ayushp06/hackathon-fa26/hackathonfa26 2026.pdf

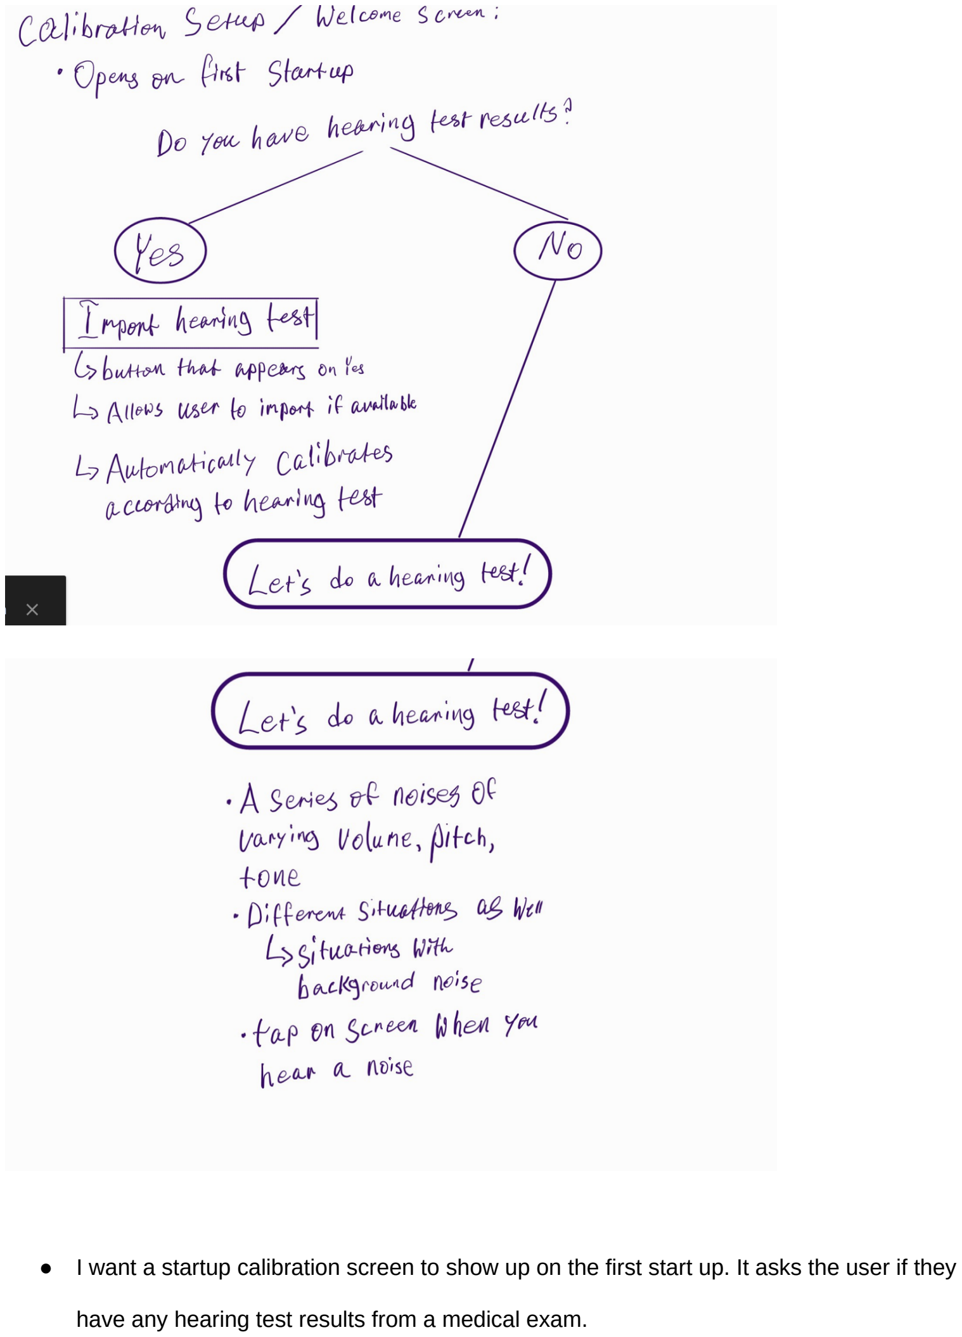
[picture p1: page 1]

- I want a startup calibration screen to show up on the first start up. It asks the user if they

have any hearing test results from a medical exam.

- If they do, it allows the user to import their own hearing test results through a pdf

file or images through an upload or import button

- If they don’t, it brings the user to another screen where they do a hearing test:

they tap the screen every time they hear a noise.

- This screen should also ask them the questions: “Which sounds do you want to be

louder?”, followed by the following headers with yes / no buttons beside them

- Vocal tones?
- Background noise?
- Emphasize softer or louder tones?

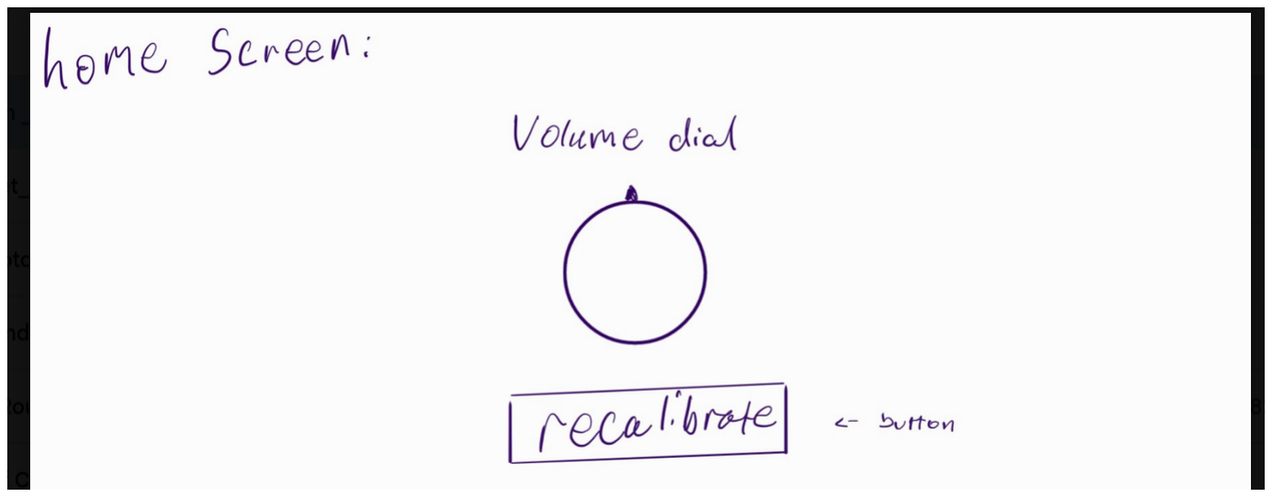
[picture p2: figure]

- This is the home screen of the app
- It only has a volume dial on it and a recalibration button
- This should be the default screen of the app after the first setup screen
- The recalibration screen should take you to the following manual calibration screen:

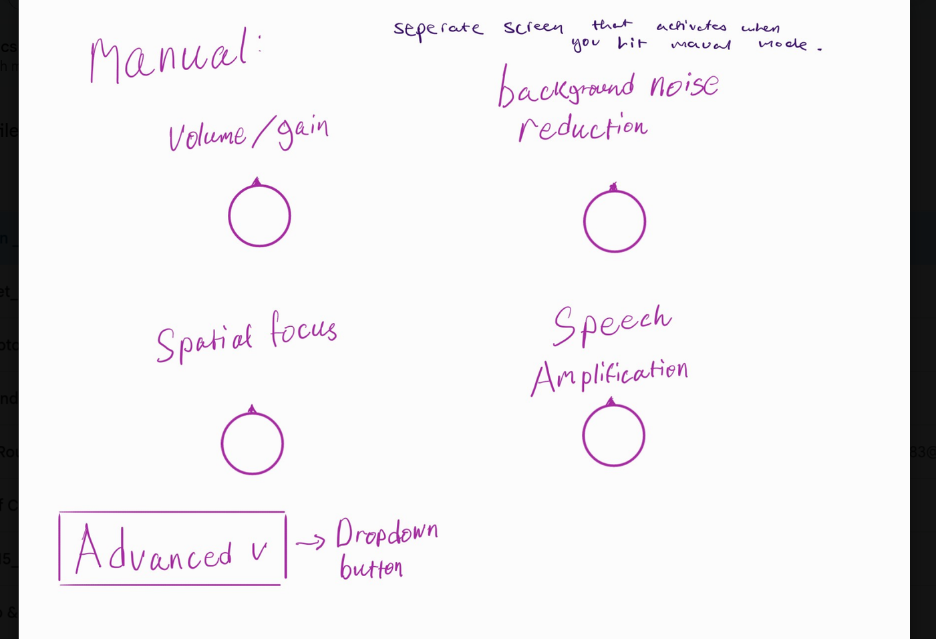
[picture p3: figure]
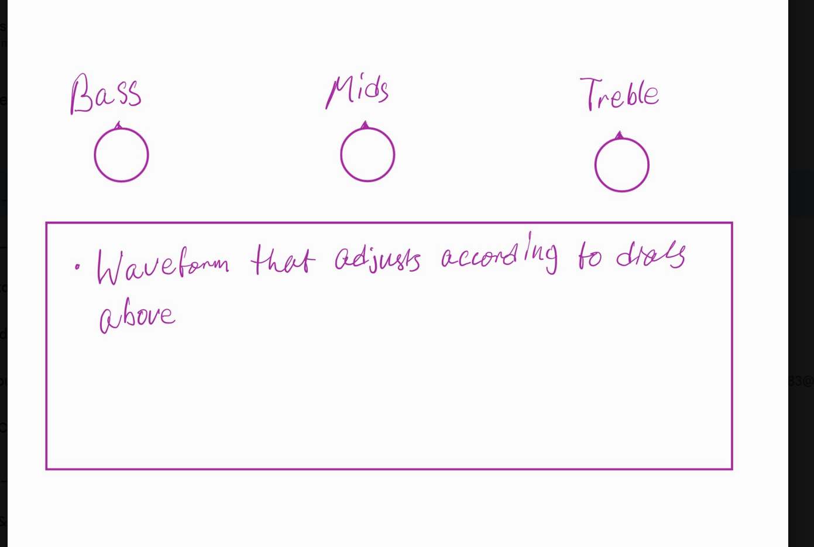
[picture p4: figure]

- This screen shows up if you change the automatic calibration / manual slider to be set to

manual.

- I want to add this advanced drop down button with bass, mid, and treble dials and a

wave form that changes according to the values of the dials
