ayushp06/hackathon-fa26/hardware/exports/AURA_breadboard_schematic.pdf

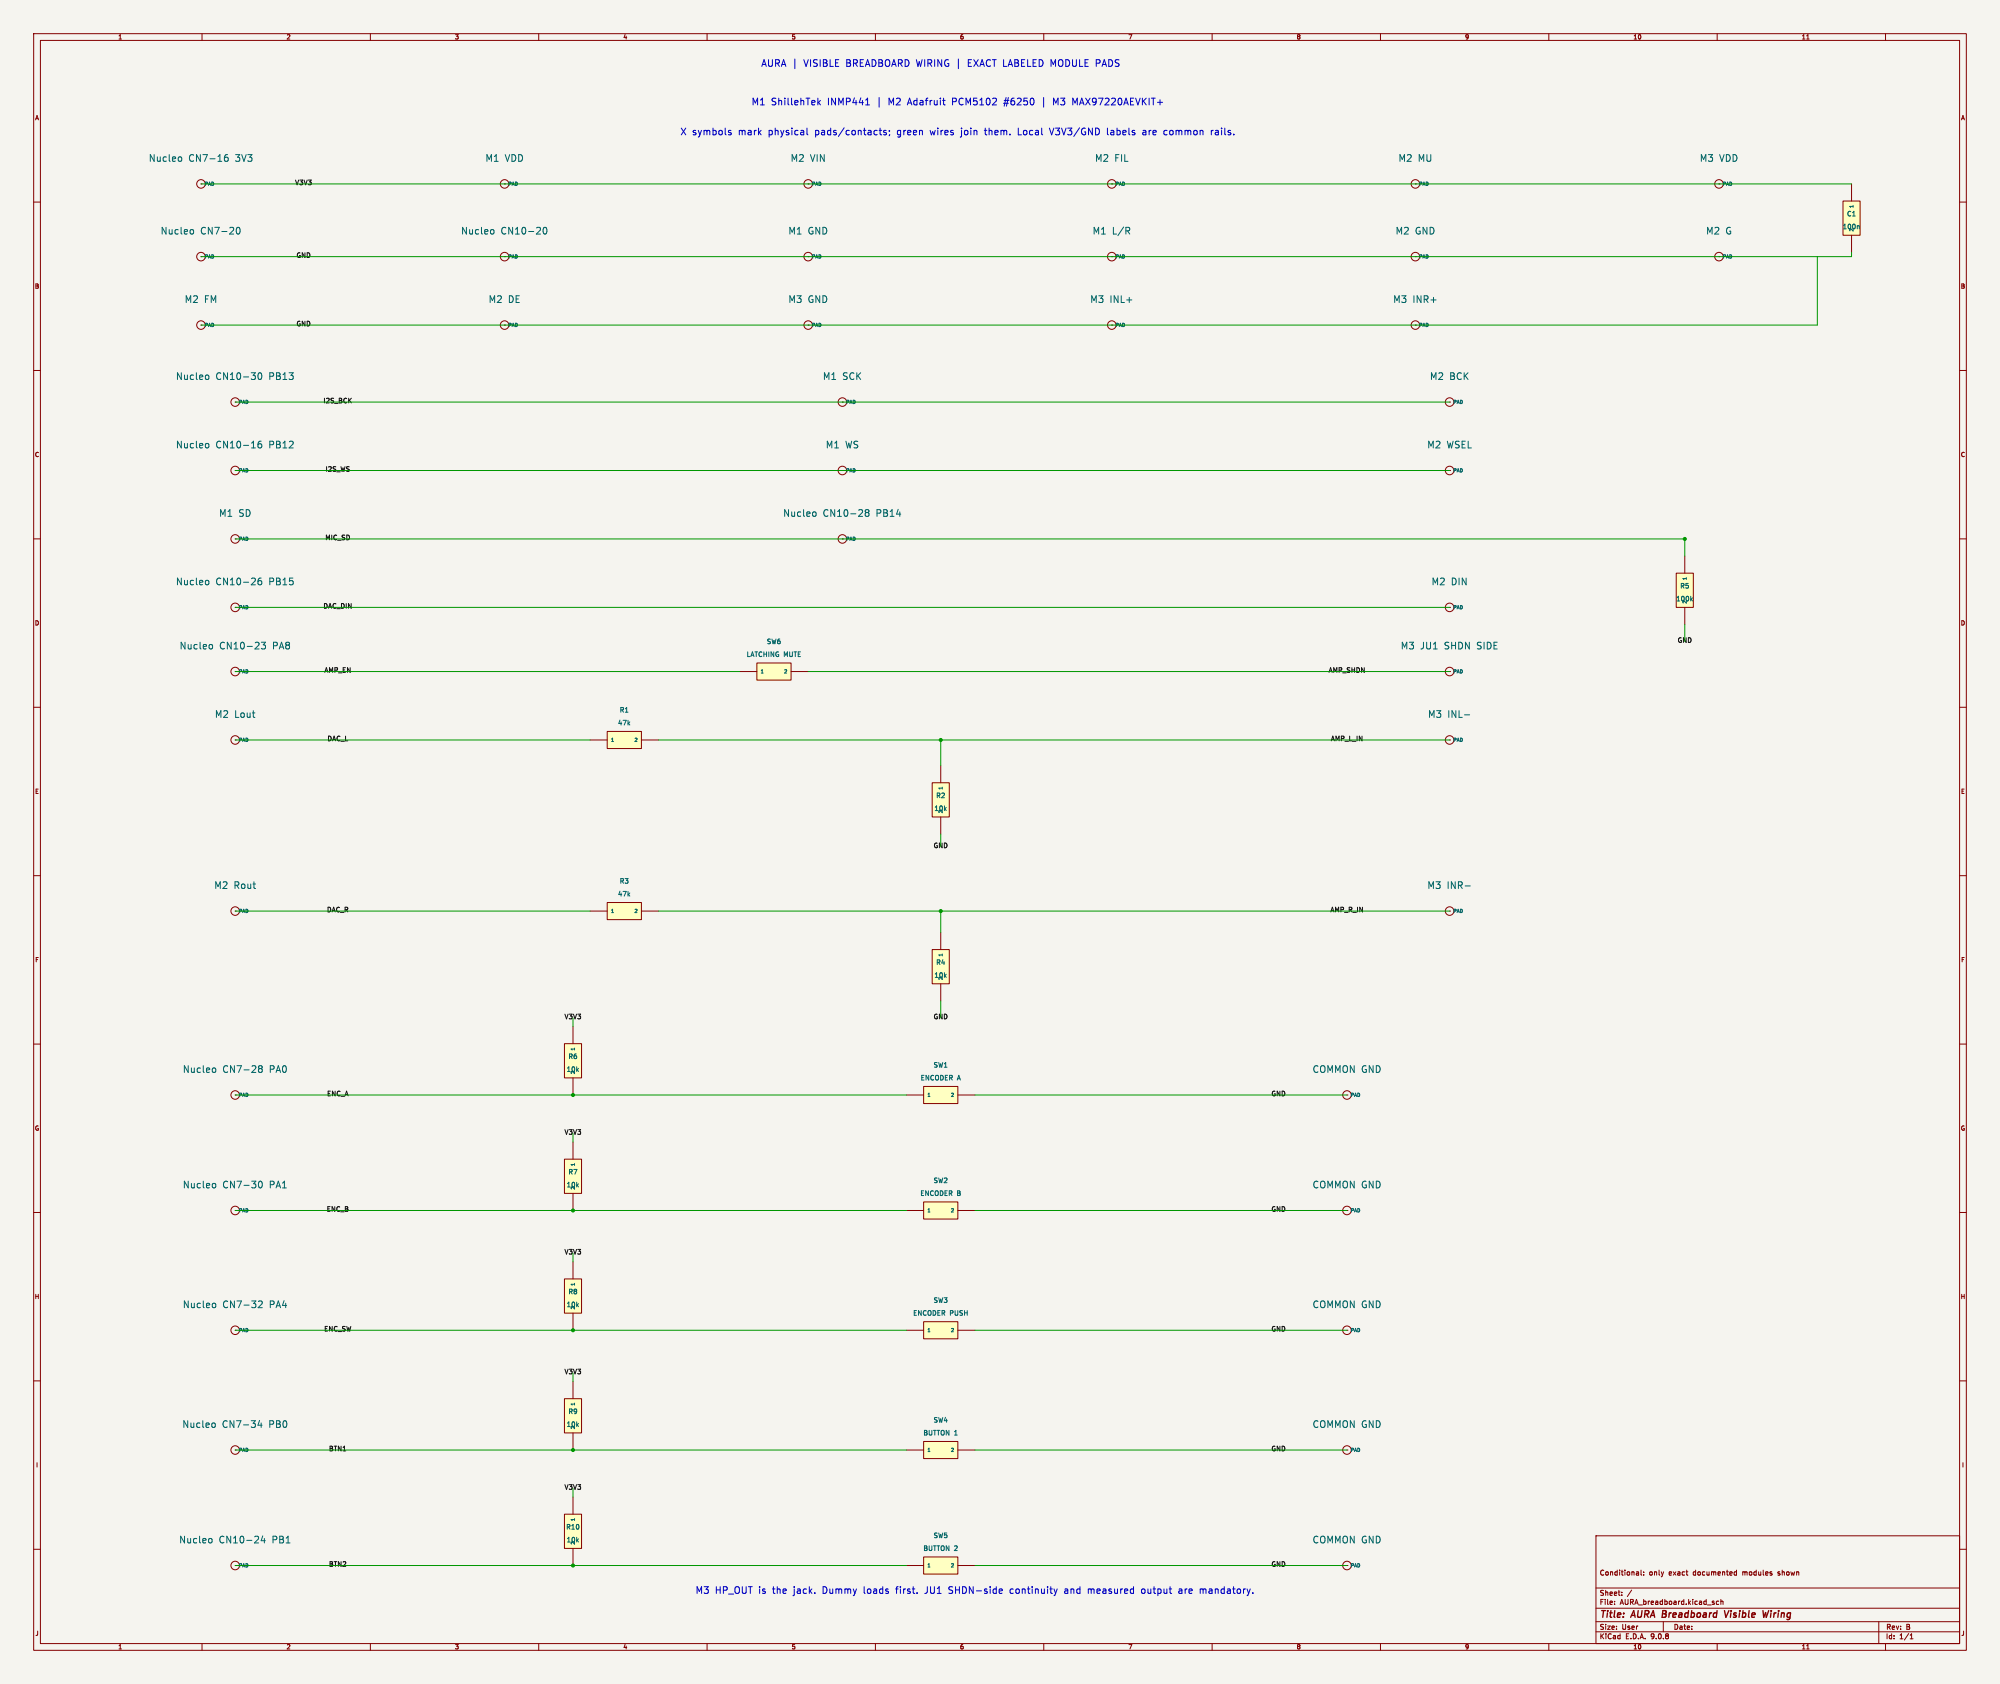
[picture p5: page 1]

AURA | VISIBLE BREADBOARD WIRING | EXACT LABELED MODULE PADS

PAD M3 INL- PAD M3 INR-
