ayushp06/hackathon-fa26/hardware/exports/AURA_circuit_schematic.pdf

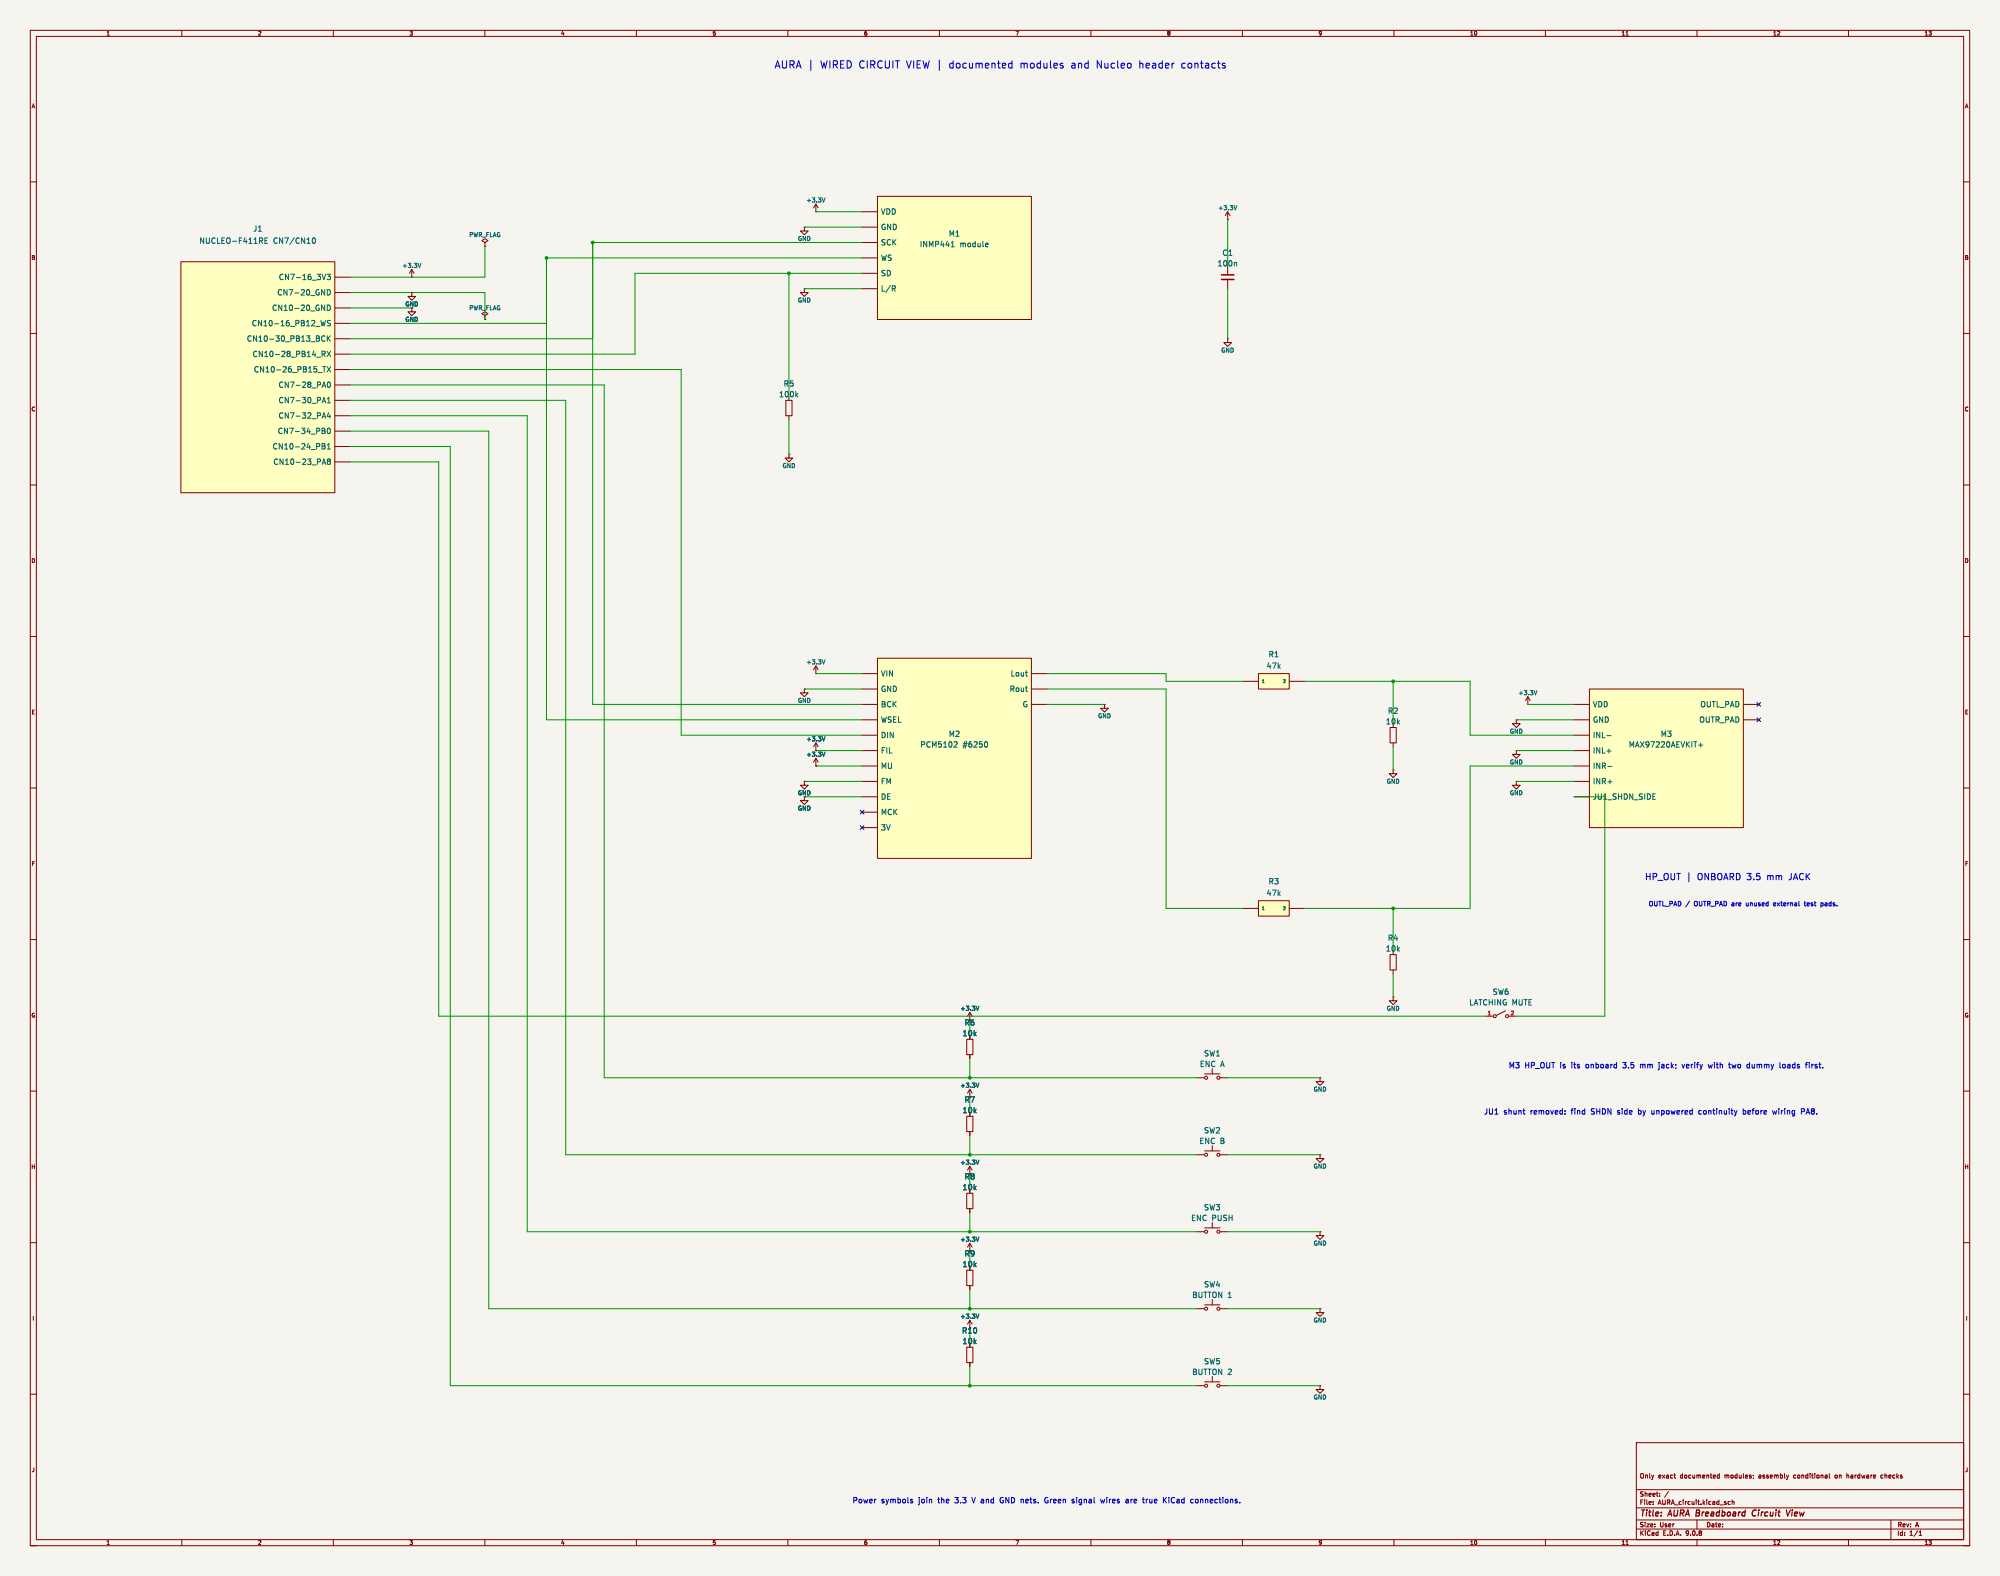
[picture p6: page 1]

M3 HP_OUT is its onboard 3.5 mm jack; verify with two dummy loads first.

Power symbols join the 3.3 V and GND nets. Green signal wires are true KiCad connections.

Id: 1/1 Title: AURA Breadboard Circuit View
