ayushp06/hackathon-fa26/hardware/AURA_schematic.pdf

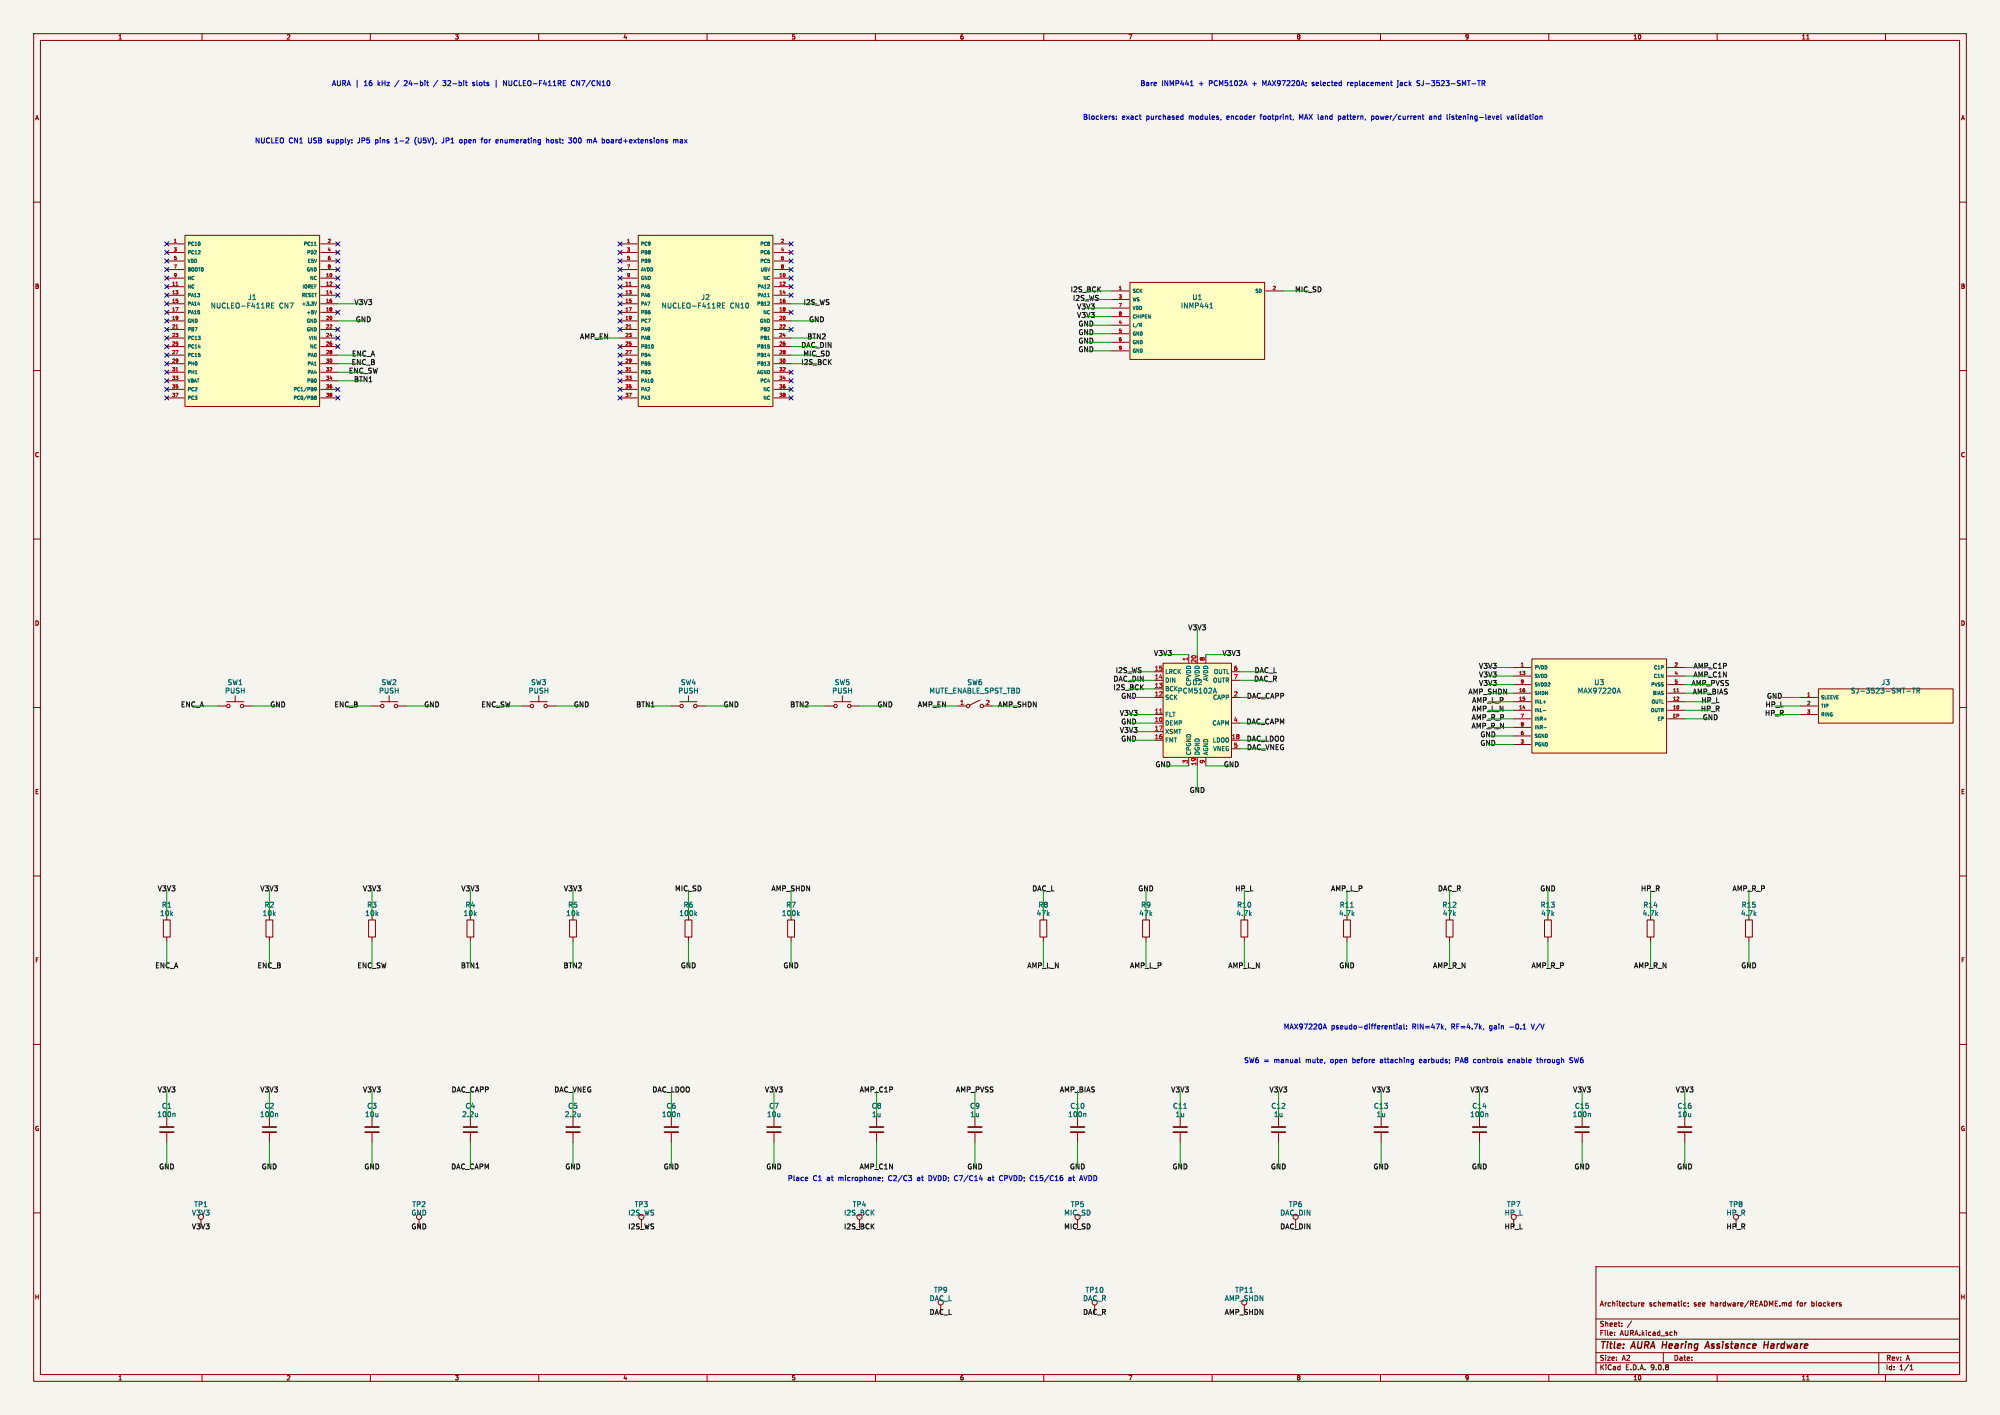
[picture p7: page 1]
