ayushp06/hackathon-fa26/hardware/AURA.kicad_sch

## KiCad design hardware/AURA.kicad_sch (2026-10-24)

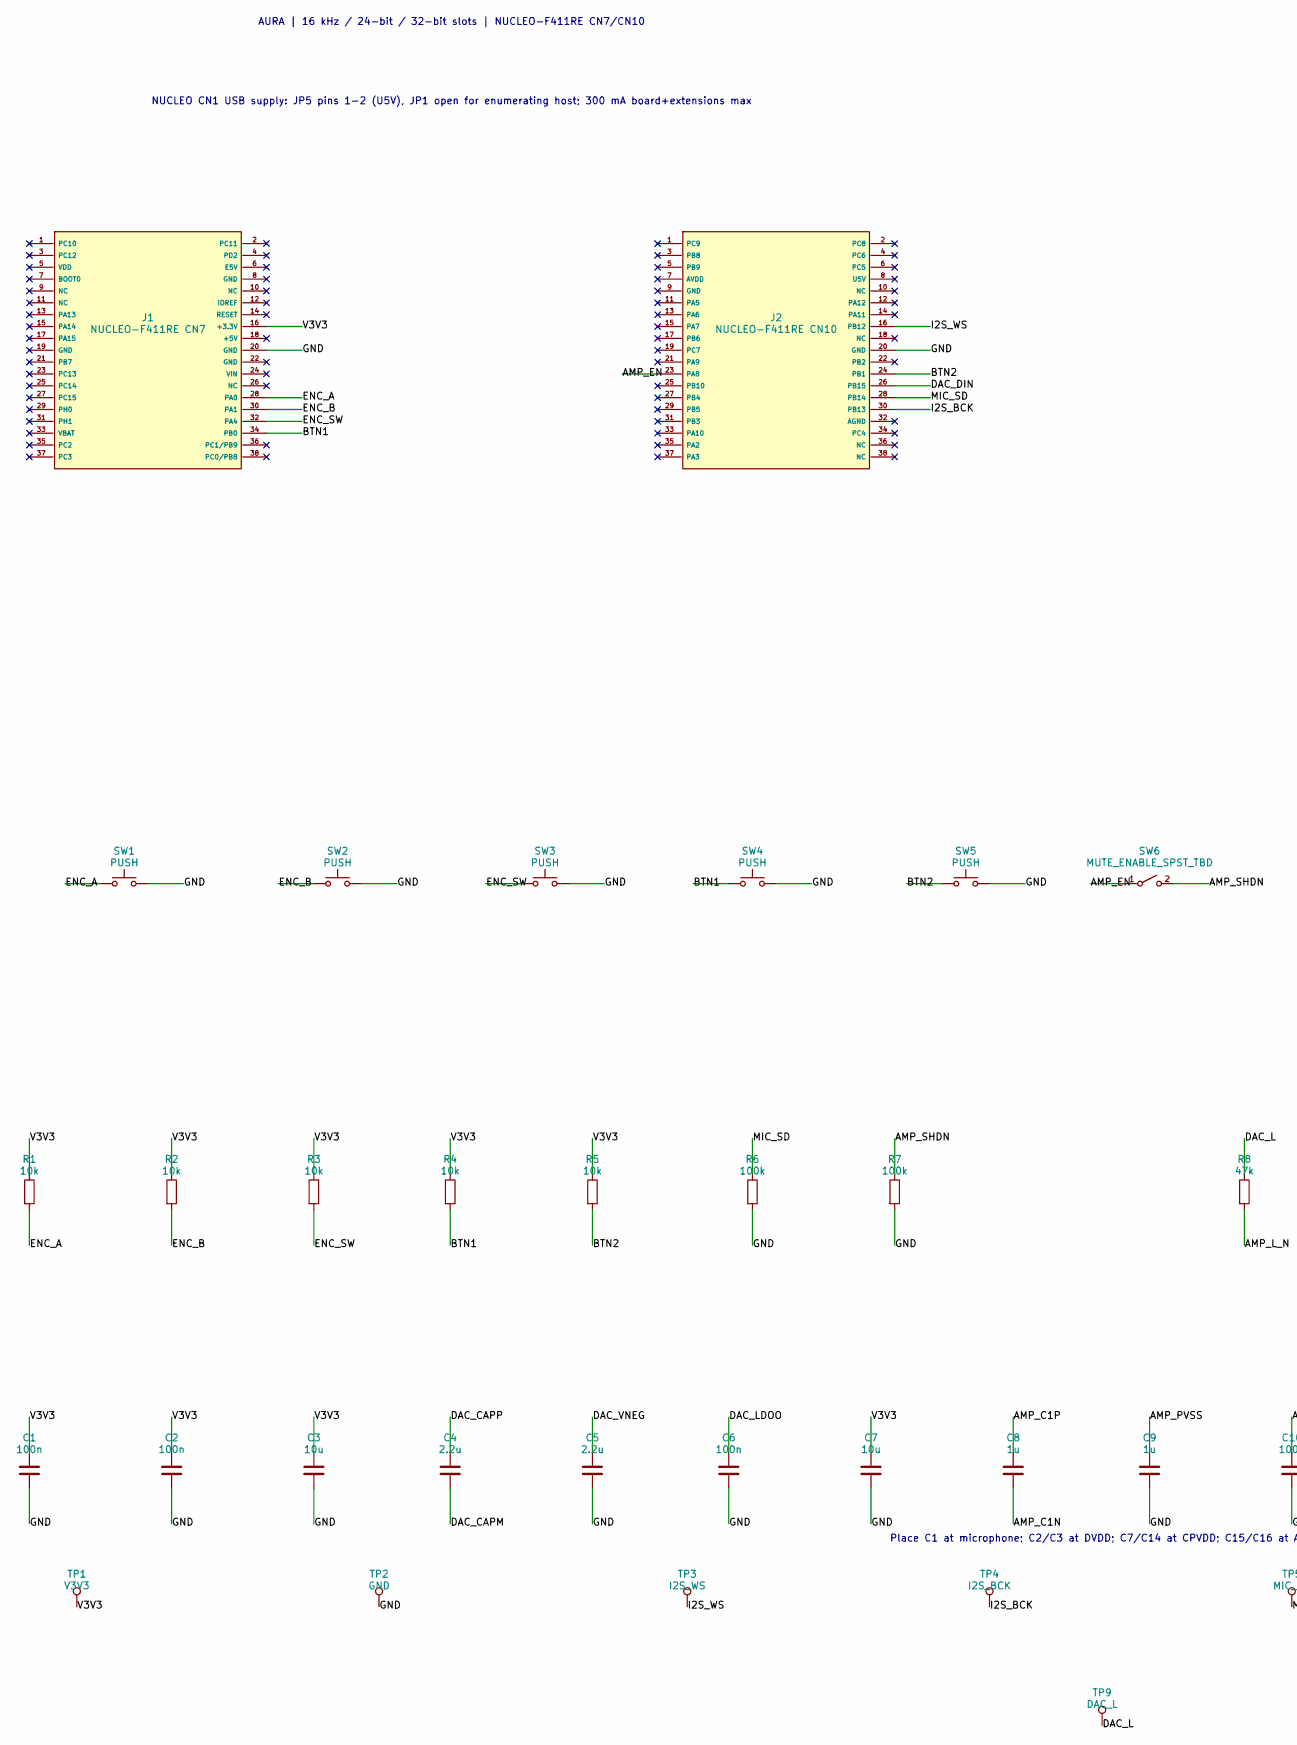
[picture p8: schematic AURA.kicad_sch, part in row 1, column 1]

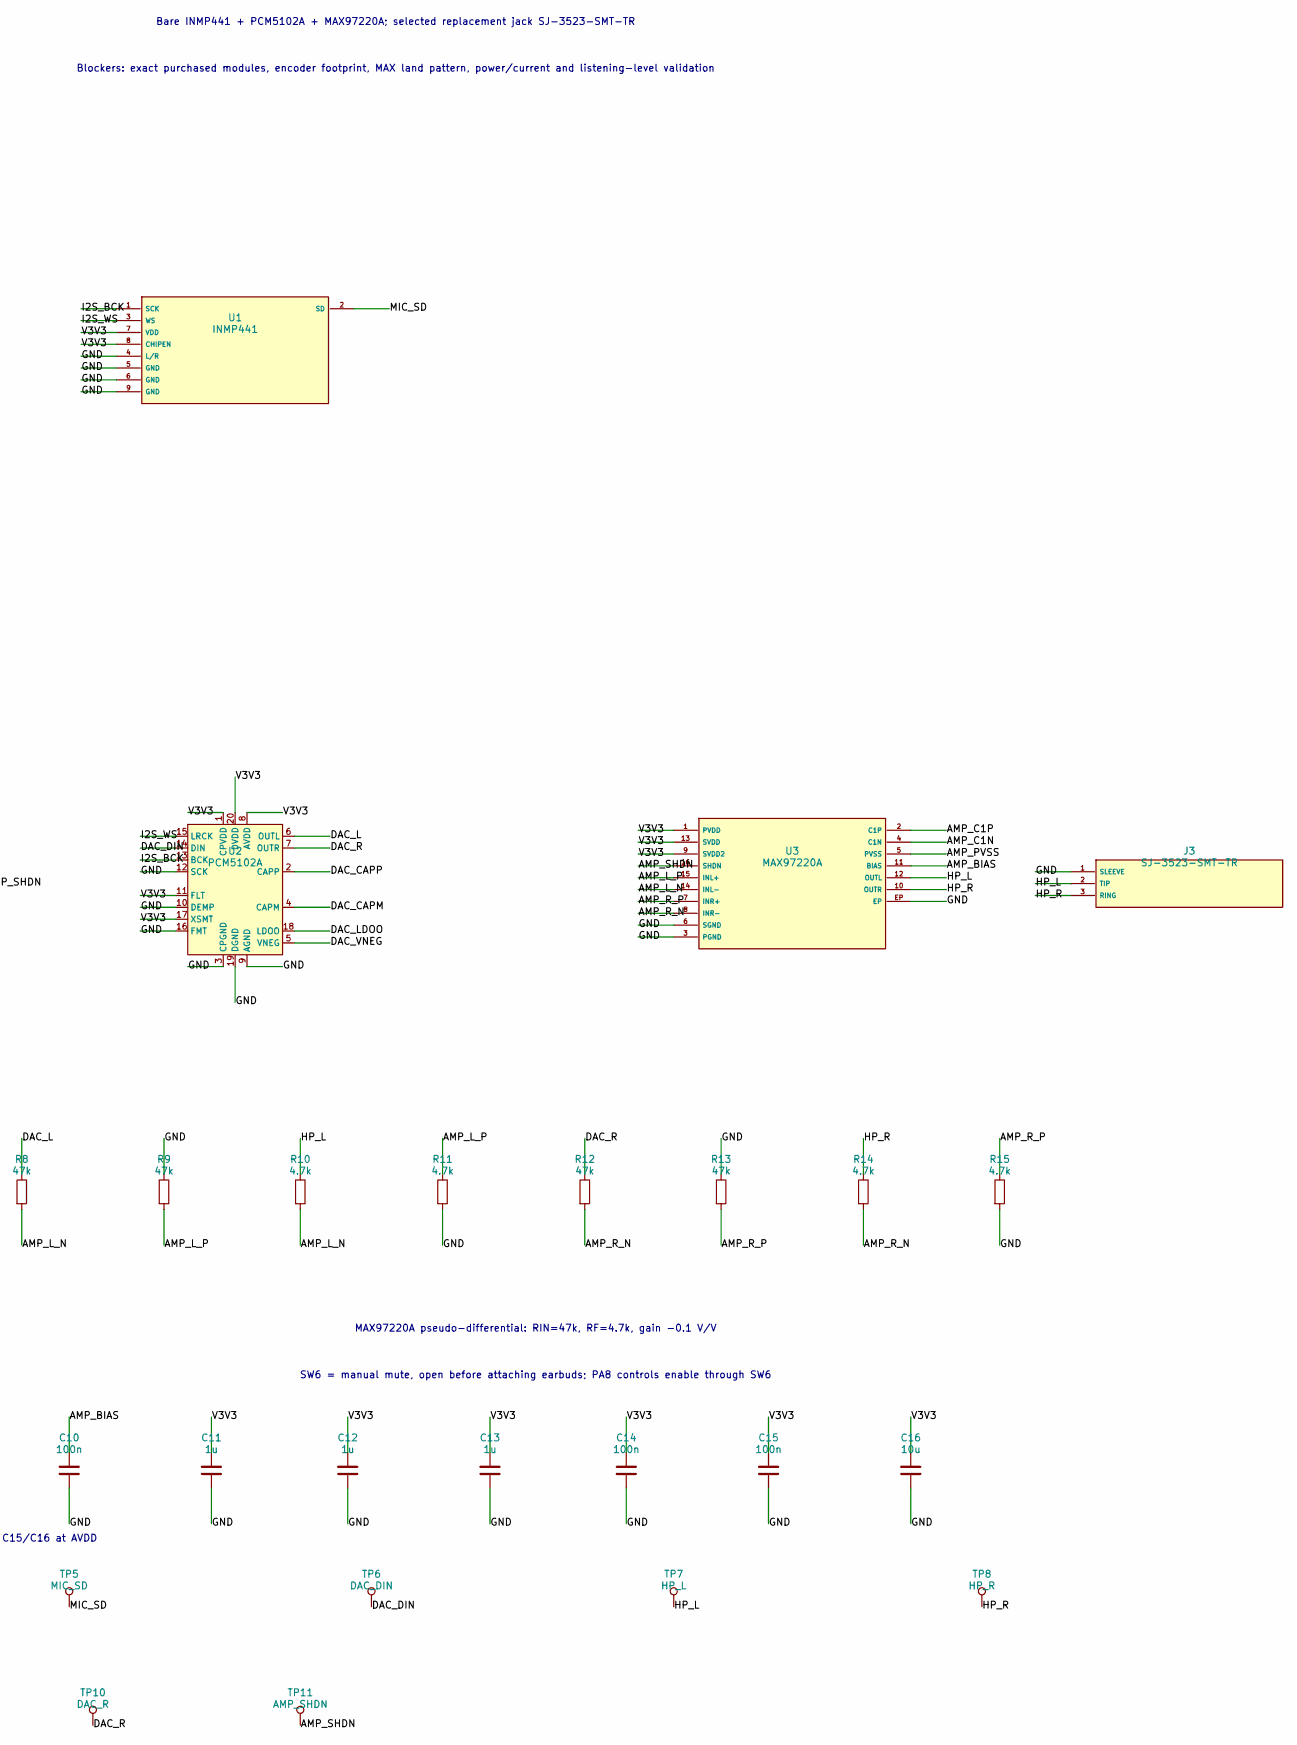
[picture p9: schematic AURA.kicad_sch, part in row 1, column 2]

Parts:
C1, C2, C6, C10, C14, C15: 100n; C_0603_1608Metric
C3, C7, C16: 10u; C_0603_1608Metric
C4, C5: 2.2u; C_0603_1608Metric
C8, C9, C11, C12, C13: 1u; C_0603_1608Metric
J1: NUCLEO-F411RE CN7
J2: NUCLEO-F411RE CN10
J3: SJ-3523-SMT-TR; Jack_3.5mm_CUI_SJ-3523-SMT-TR
R1, R2, R3, R4, R5: 10k; R_0603_1608Metric
R6, R7: 100k; R_0603_1608Metric
R8, R9, R12, R13: 47k; R_0603_1608Metric
R10, R11, R14, R15: 4.7k; R_0603_1608Metric
SW1, SW2, SW3, SW4, SW5: PUSH
SW6: MUTE_ENABLE_SPST_TBD
TP1: V3V3
TP2: GND
TP3: I2S_WS
TP4: I2S_BCK
TP5: MIC_SD
TP6: DAC_DIN
TP7: HP_L
TP8: HP_R
TP9: DAC_L
TP10: DAC_R
TP11: AMP_SHDN
U1: INMP441
U2: PCM5102A; TSSOP-20_4.4x6.5mm_P0.65mm
U3: MAX97220A

Connections:
AMP_BIAS: C10.1, U3.11 (BIAS)
AMP_C1N: C8.2, U3.4 (C1N)
AMP_C1P: C8.1, U3.2 (C1P)
AMP_EN: J2.23 (PA8), SW6.1 (A)
AMP_L_N: R8.2, R10.2, U3.14 (INL-)
AMP_L_P: R9.2, R11.1, U3.15 (INL+)
AMP_PVSS: C9.1, U3.5 (PVSS)
AMP_R_N: R12.2, R14.2, U3.8 (INR-)
AMP_R_P: R13.2, R15.1, U3.7 (INR+)
AMP_SHDN: R7.1, SW6.2 (B), TP11.1, U3.16 (SHDN)
BTN1: J1.34 (PB0), R4.2, SW4.1
BTN2: J2.24 (PB1), R5.2, SW5.1
DAC_CAPM: C4.2, U2.4 (CAPM)
DAC_CAPP: C4.1, U2.2 (CAPP)
DAC_DIN: J2.26 (PB15), TP6.1, U2.14 (DIN)
DAC_L: R8.1, TP9.1, U2.6 (OUTL)
DAC_LDOO: C6.1, U2.18 (LDOO)
DAC_R: R12.1, TP10.1, U2.7 (OUTR)
DAC_VNEG: C5.1, U2.5 (VNEG)
ENC_A: J1.28 (PA0), R1.2, SW1.1
ENC_B: J1.30 (PA1), R2.2, SW2.1
ENC_SW: J1.32 (PA4), R3.2, SW3.1
GND: C1.2, C2.2, C3.2, C5.2, C6.2, C7.2, C9.2, C10.2, C11.2, C12.2, C13.2, C14.2, C15.2, C16.2, J1.20 (GND), J2.20 (GND), J3.1 (SLEEVE), R6.2, R7.2, R9.1, R11.2, R13.1, R15.2, SW1.2, SW2.2, SW3.2, SW4.2, SW5.2, TP2.1, U1.4 (L/R), U1.5 (GND), U1.6 (GND), U1.9 (GND), U2.3 (CPGND), U2.9 (AGND), U2.10 (DEMP), U2.12 (SCK), U2.16 (FMT), U2.19 (DGND), U3.3 (PGND), U3.6 (SGND), U3.EP
HP_L: J3.2 (TIP), R10.1, TP7.1, U3.12 (OUTL)
HP_R: J3.3 (RING), R14.1, TP8.1, U3.10 (OUTR)
I2S_BCK: J2.30 (PB13), TP4.1, U1.1 (SCK), U2.13 (BCK)
I2S_WS: J2.16 (PB12), TP3.1, U1.3 (WS), U2.15 (LRCK)
MIC_SD: J2.28 (PB14), R6.1, TP5.1, U1.2 (SD)
V3V3: C1.1, C2.1, C3.1, C7.1, C11.1, C12.1, C13.1, C14.1, C15.1, C16.1, J1.16 (+3.3V), R1.1, R2.1, R3.1, R4.1, R5.1, TP1.1, U1.7 (VDD), U1.8 (CHIPEN), U2.1 (CPVDD), U2.8 (AVDD), U2.11 (FLT), U2.17 (XSMT), U2.20 (DVDD), U3.1 (PVDD), U3.9 (SVDD2), U3.13 (SVDD)

Notes on the sheet:
AURA | 16 kHz / 24-bit / 32-bit slots | NUCLEO-F411RE CN7/CN10
Bare INMP441 + PCM5102A + MAX97220A; selected replacement jack SJ-3523-SMT-TR
Blockers: exact purchased modules, encoder footprint, MAX land pattern, power/current and listening-level validation
NUCLEO CN1 USB supply: JP5 pins 1-2 (U5V), JP1 open for enumerating host; 300 mA board+extensions max
MAX97220A pseudo-differential: RIN=47k, RF=4.7k, gain -0.1 V/V
SW6 = manual mute, open before attaching earbuds; PA8 controls enable through SW6
Place C1 at microphone; C2/C3 at DVDD; C7/C14 at CPVDD; C15/C16 at AVDD
