ayushp06/hackathon-fa26/hardware/AURA_breadboard.kicad_sch

## KiCad design hardware/AURA_breadboard.kicad_sch (2026-10-24)

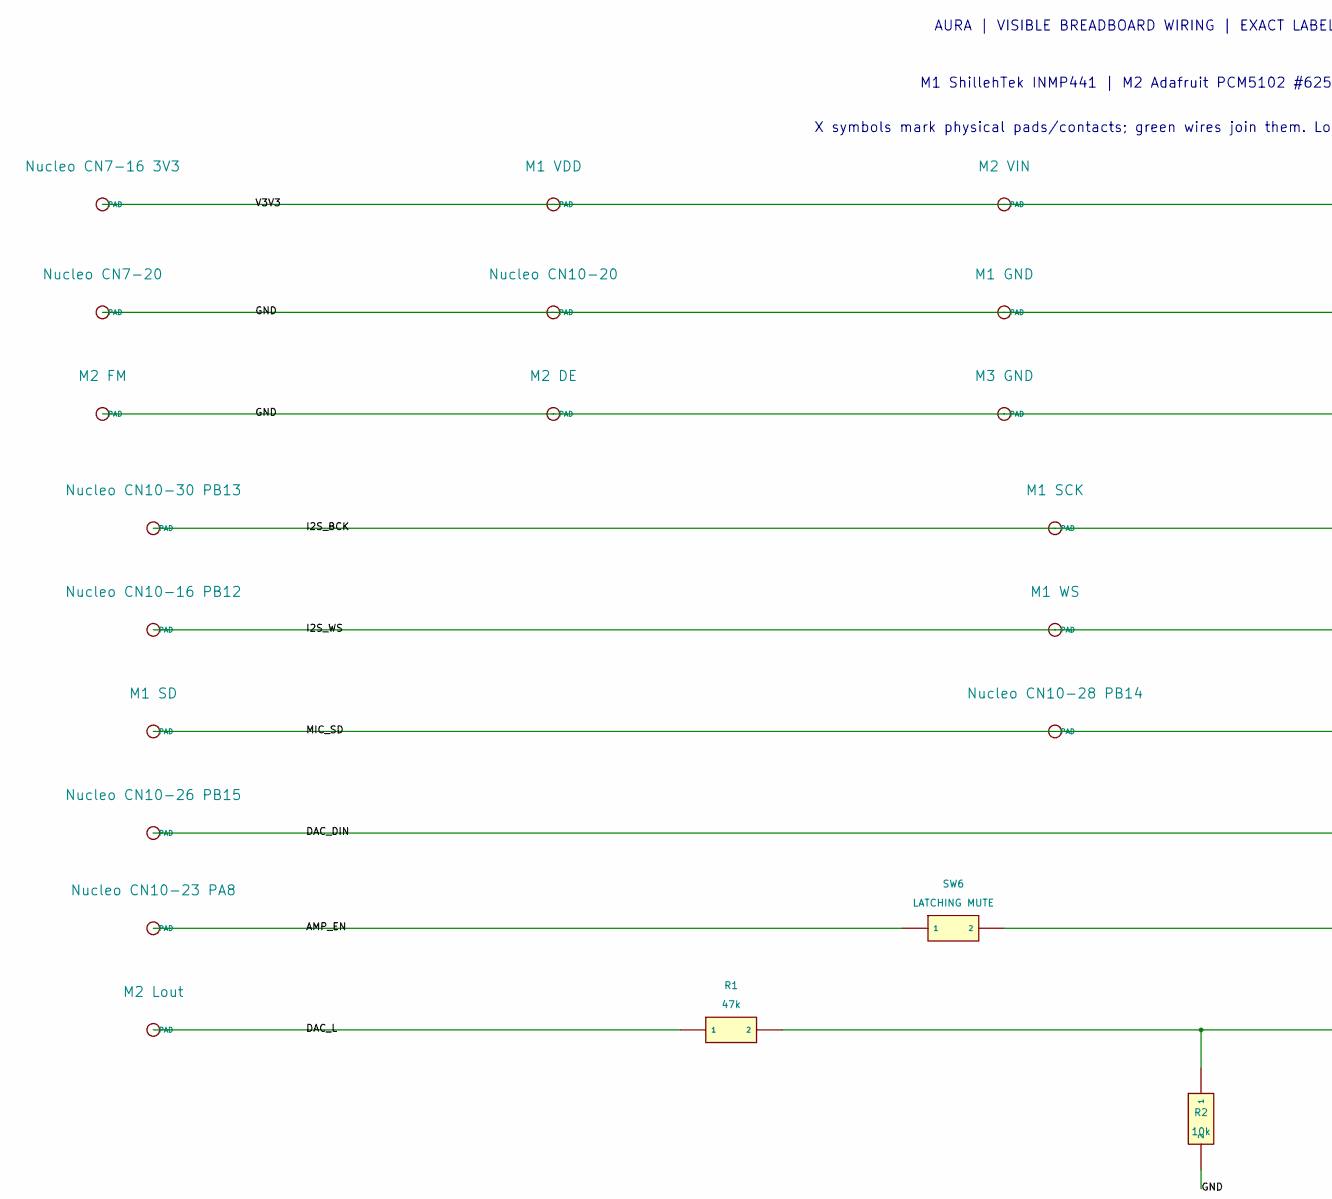
[picture p10: schematic AURA_breadboard.kicad_sch, part in row 1, column 1]

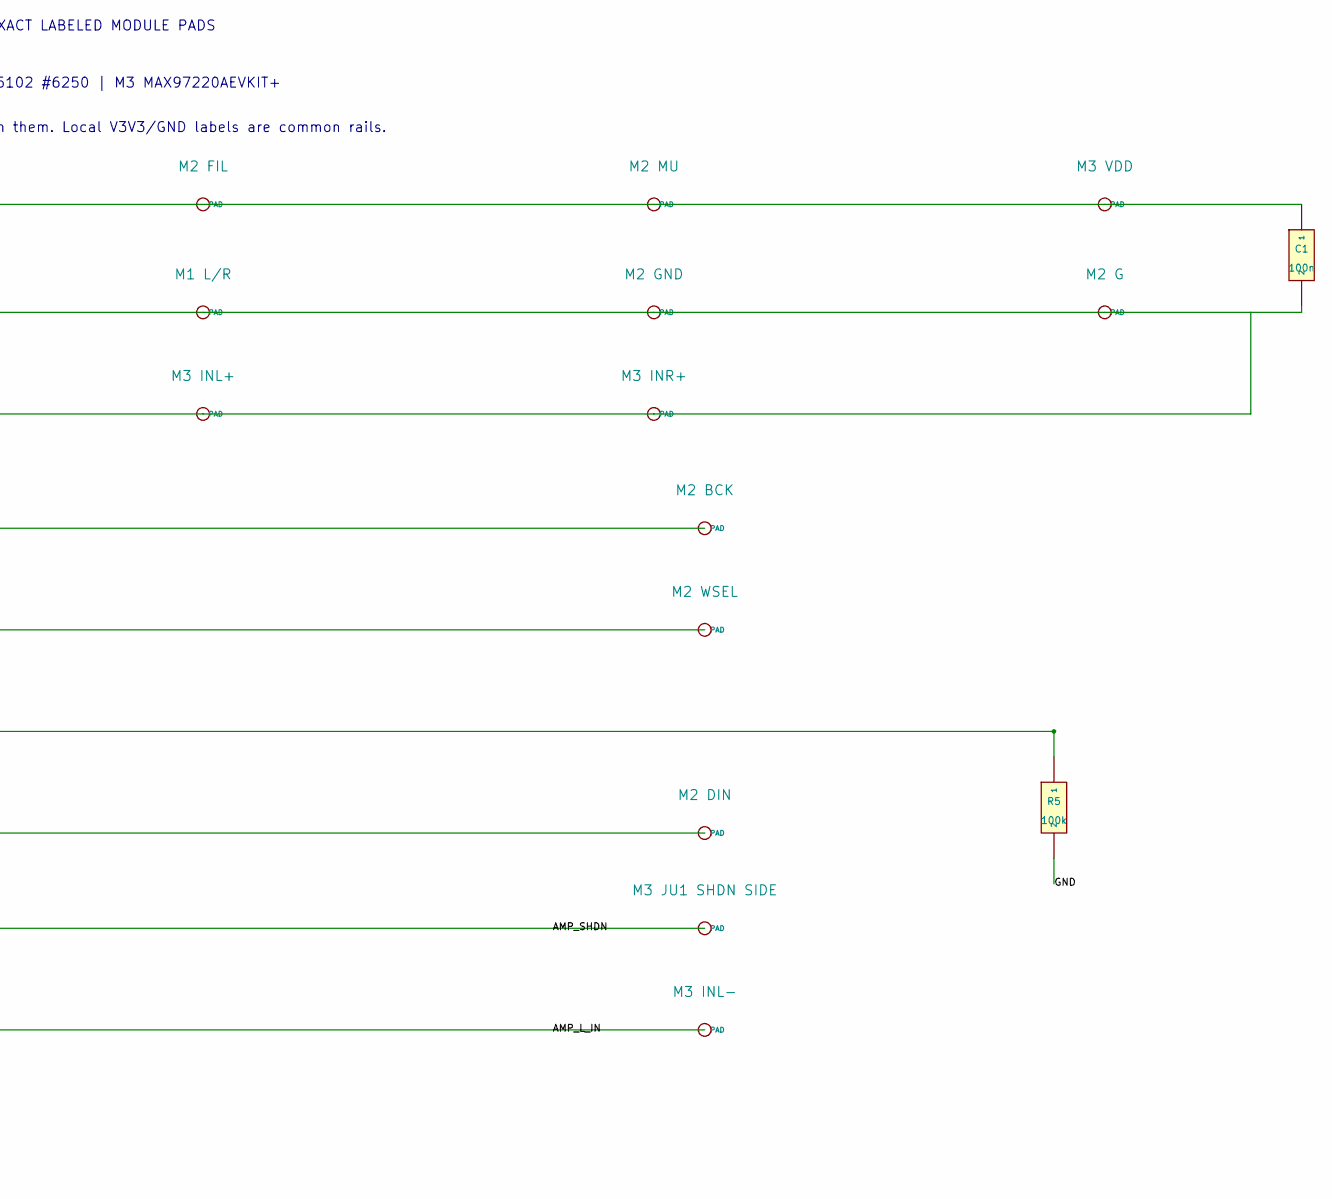
[picture p11: schematic AURA_breadboard.kicad_sch, part in row 1, column 2]

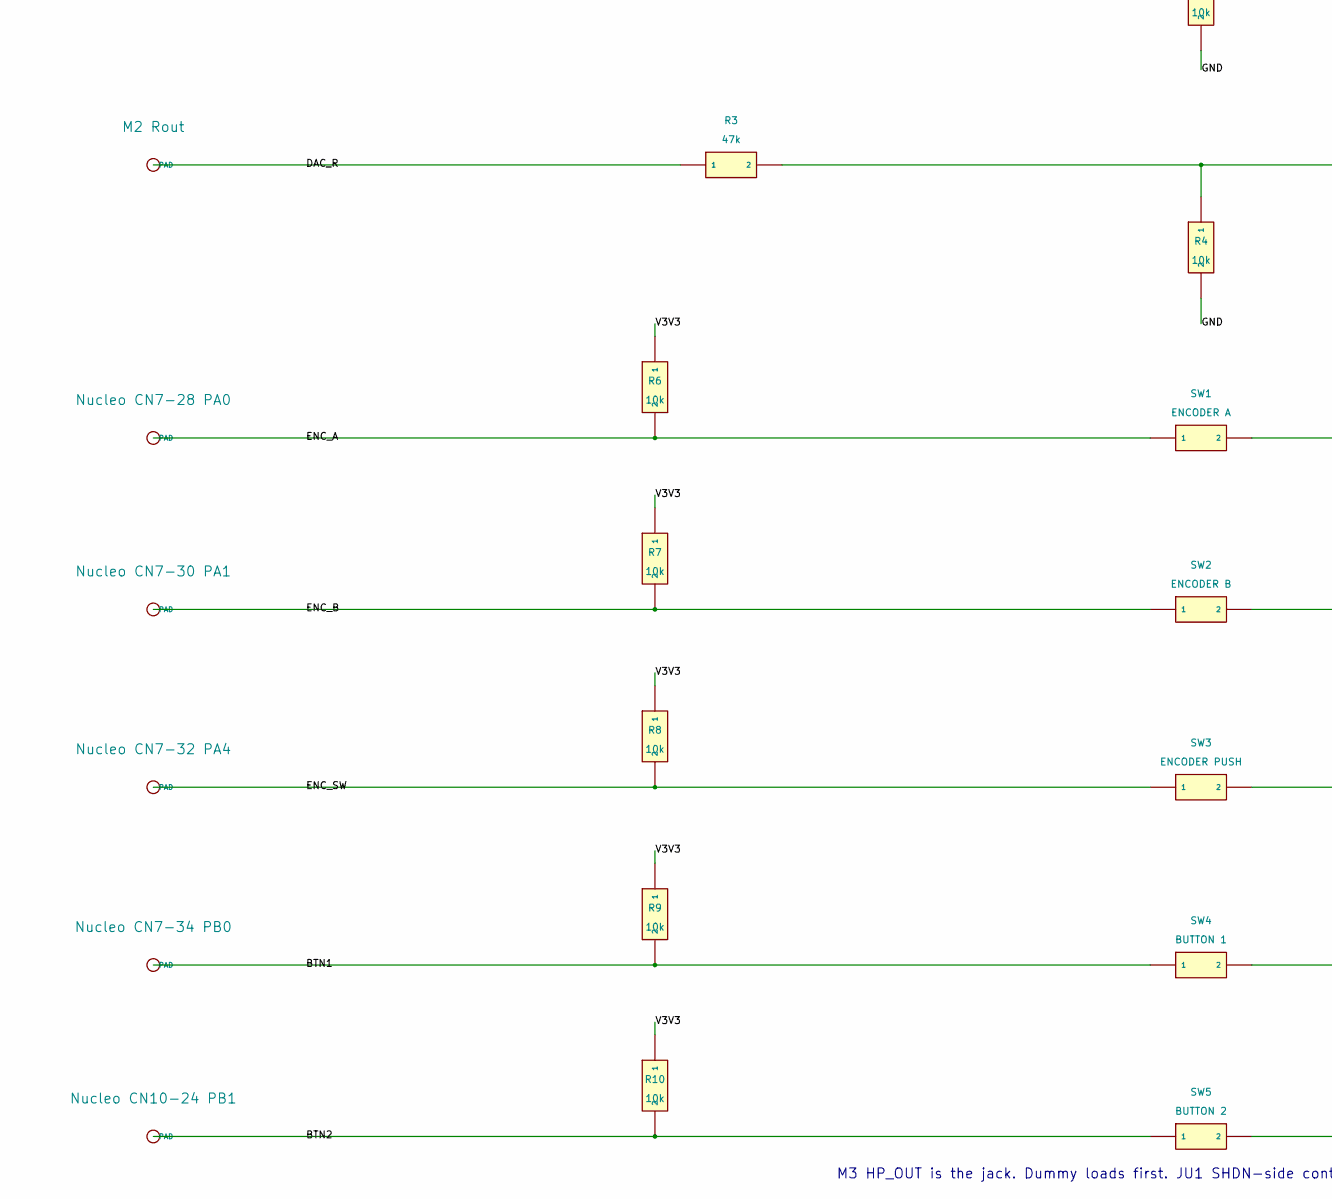
[picture p12: schematic AURA_breadboard.kicad_sch, part in row 2, column 1]

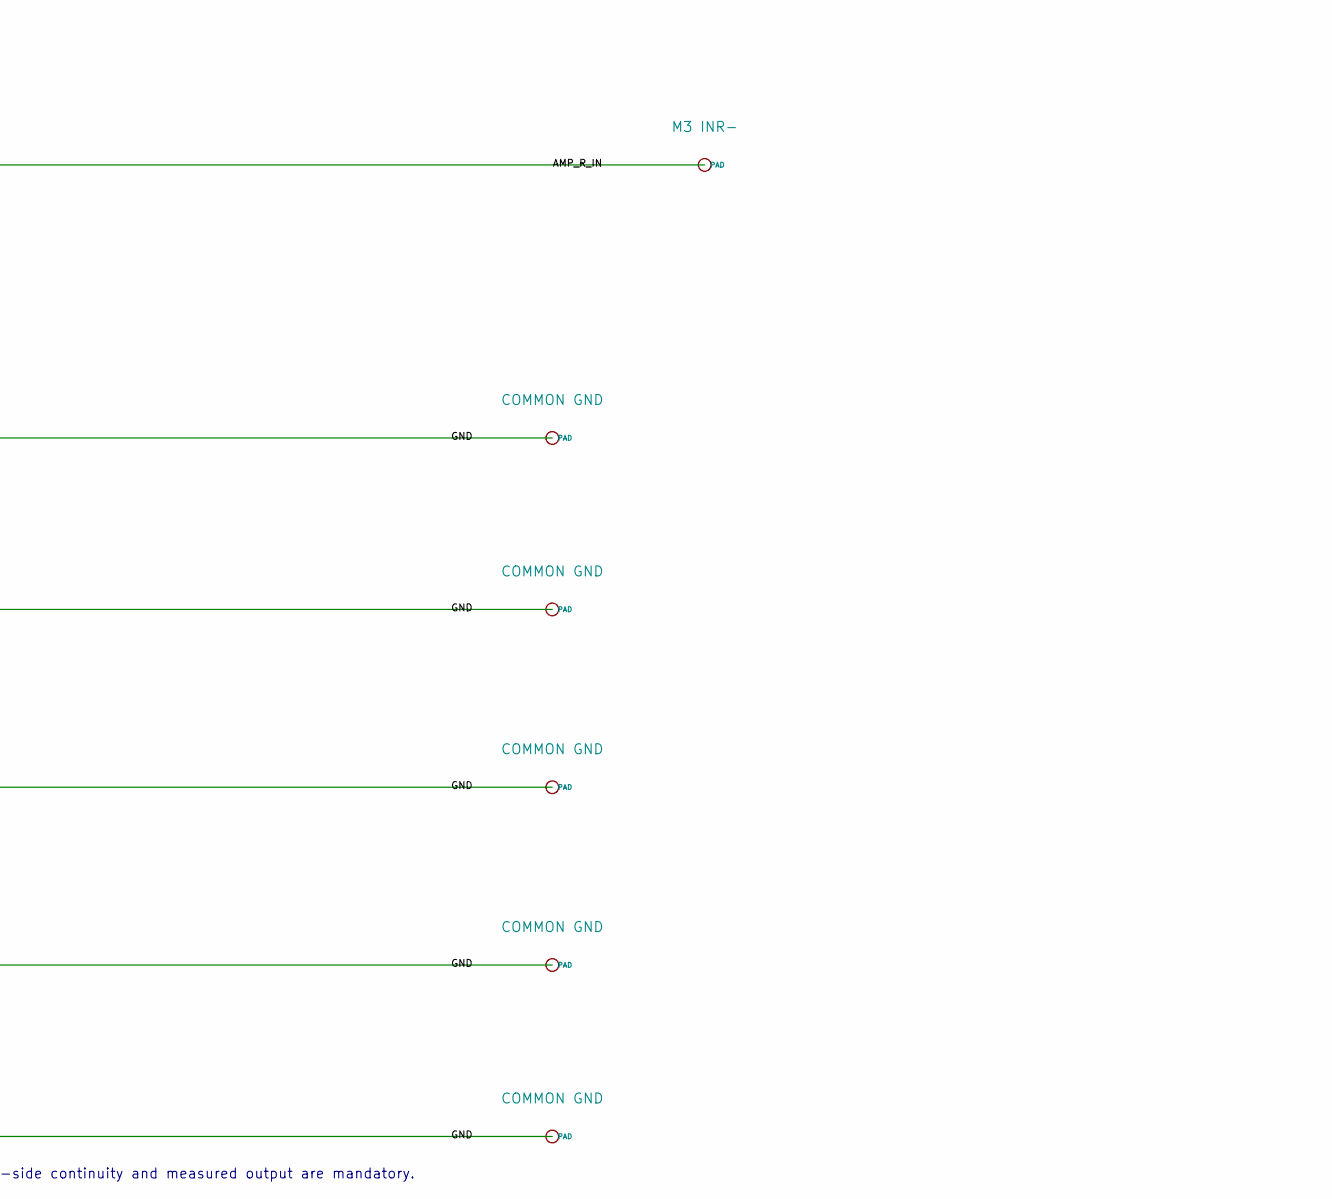
[picture p13: schematic AURA_breadboard.kicad_sch, part in row 2, column 2]

Parts:
C1: 100n
R1, R3: 47k
R2, R4, R6, R7, R8, R9, R10: 10k
R5: 100k
SW1: ENCODER A
SW2: ENCODER B
SW3: ENCODER PUSH
SW4: BUTTON 1
SW5: BUTTON 2
SW6: LATCHING MUTE
X1: Nucleo CN7-16 3V3
X2: M1 VDD
X3: M2 VIN
X4: M2 FIL
X5: M2 MU
X6: M3 VDD
X7: Nucleo CN7-20
X8: Nucleo CN10-20
X9: M1 GND
X10: M1 L/R
X11: M2 GND
X12: M2 G
X13: M2 FM
X14: M2 DE
X15: M3 GND
X16: M3 INL+
X17: M3 INR+
X18: Nucleo CN10-30 PB13
X19: M1 SCK
X20: M2 BCK
X21: Nucleo CN10-16 PB12
X22: M1 WS
X23: M2 WSEL
X24: M1 SD
X25: Nucleo CN10-28 PB14
X26: Nucleo CN10-26 PB15
X27: M2 DIN
X28: Nucleo CN10-23 PA8
X29: M3 JU1 SHDN SIDE
X30: M2 Lout
X31: M3 INL-
X32: M2 Rout
X33: M3 INR-
X34: Nucleo CN7-28 PA0
X35, X37, X39, X41, X43: COMMON GND
X36: Nucleo CN7-30 PA1
X38: Nucleo CN7-32 PA4
X40: Nucleo CN7-34 PB0
X42: Nucleo CN10-24 PB1

Connections:
AMP_EN: SW6.1, X28.1
AMP_L_IN: R1.2, R2.1, X31.1
AMP_R_IN: R3.2, R4.1, X33.1
AMP_SHDN: SW6.2, X29.1
BTN1: R9.2, SW4.1, X40.1
BTN2: R10.2, SW5.1, X42.1
DAC_DIN: X26.1, X27.1
DAC_L: R1.1, X30.1
DAC_R: R3.1, X32.1
ENC_A: R6.2, SW1.1, X34.1
ENC_B: R7.2, SW2.1, X36.1
ENC_SW: R8.2, SW3.1, X38.1
GND: C1.2, R2.2, R4.2, R5.2, SW1.2, SW2.2, SW3.2, SW4.2, SW5.2, X7.1, X8.1, X9.1, X10.1, X11.1, X12.1, X13.1, X14.1, X15.1, X16.1, X17.1, X35.1, X37.1, X39.1, X41.1, X43.1
I2S_BCK: X18.1, X19.1, X20.1
I2S_WS: X21.1, X22.1, X23.1
MIC_SD: R5.1, X24.1, X25.1
V3V3: C1.1, R6.1, R7.1, R8.1, R9.1, R10.1, X1.1, X2.1, X3.1, X4.1, X5.1, X6.1

Notes on the sheet:
AURA | VISIBLE BREADBOARD WIRING | EXACT LABELED MODULE PADS
M1 ShillehTek INMP441 | M2 Adafruit PCM5102 #6250 | M3 MAX97220AEVKIT+
X symbols mark physical pads/contacts; green wires join them. Local V3V3/GND labels are common rails.
M3 HP_OUT is the jack. Dummy loads first. JU1 SHDN-side continuity and measured output are mandatory.
