ayushp06/hackathon-fa26/hardware/AURA_circuit.kicad_sch

## KiCad design hardware/AURA_circuit.kicad_sch (2026-10-24)

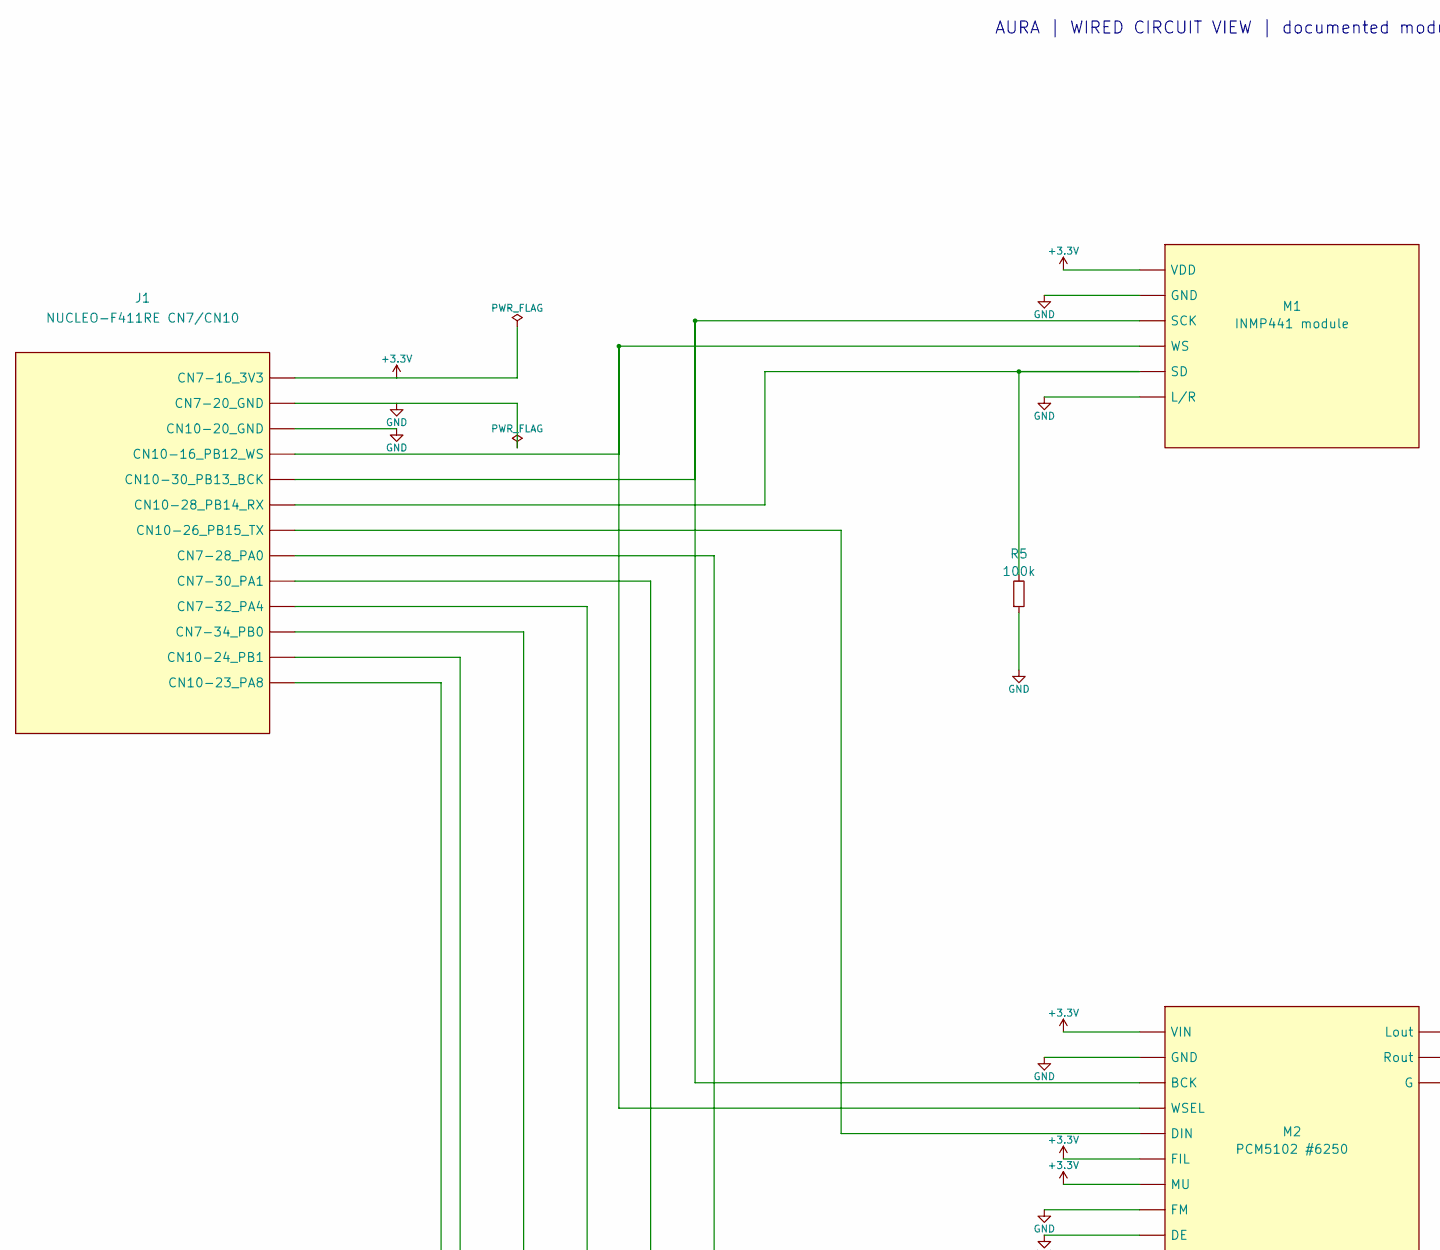
[picture p14: schematic AURA_circuit.kicad_sch, part in row 1, column 1]

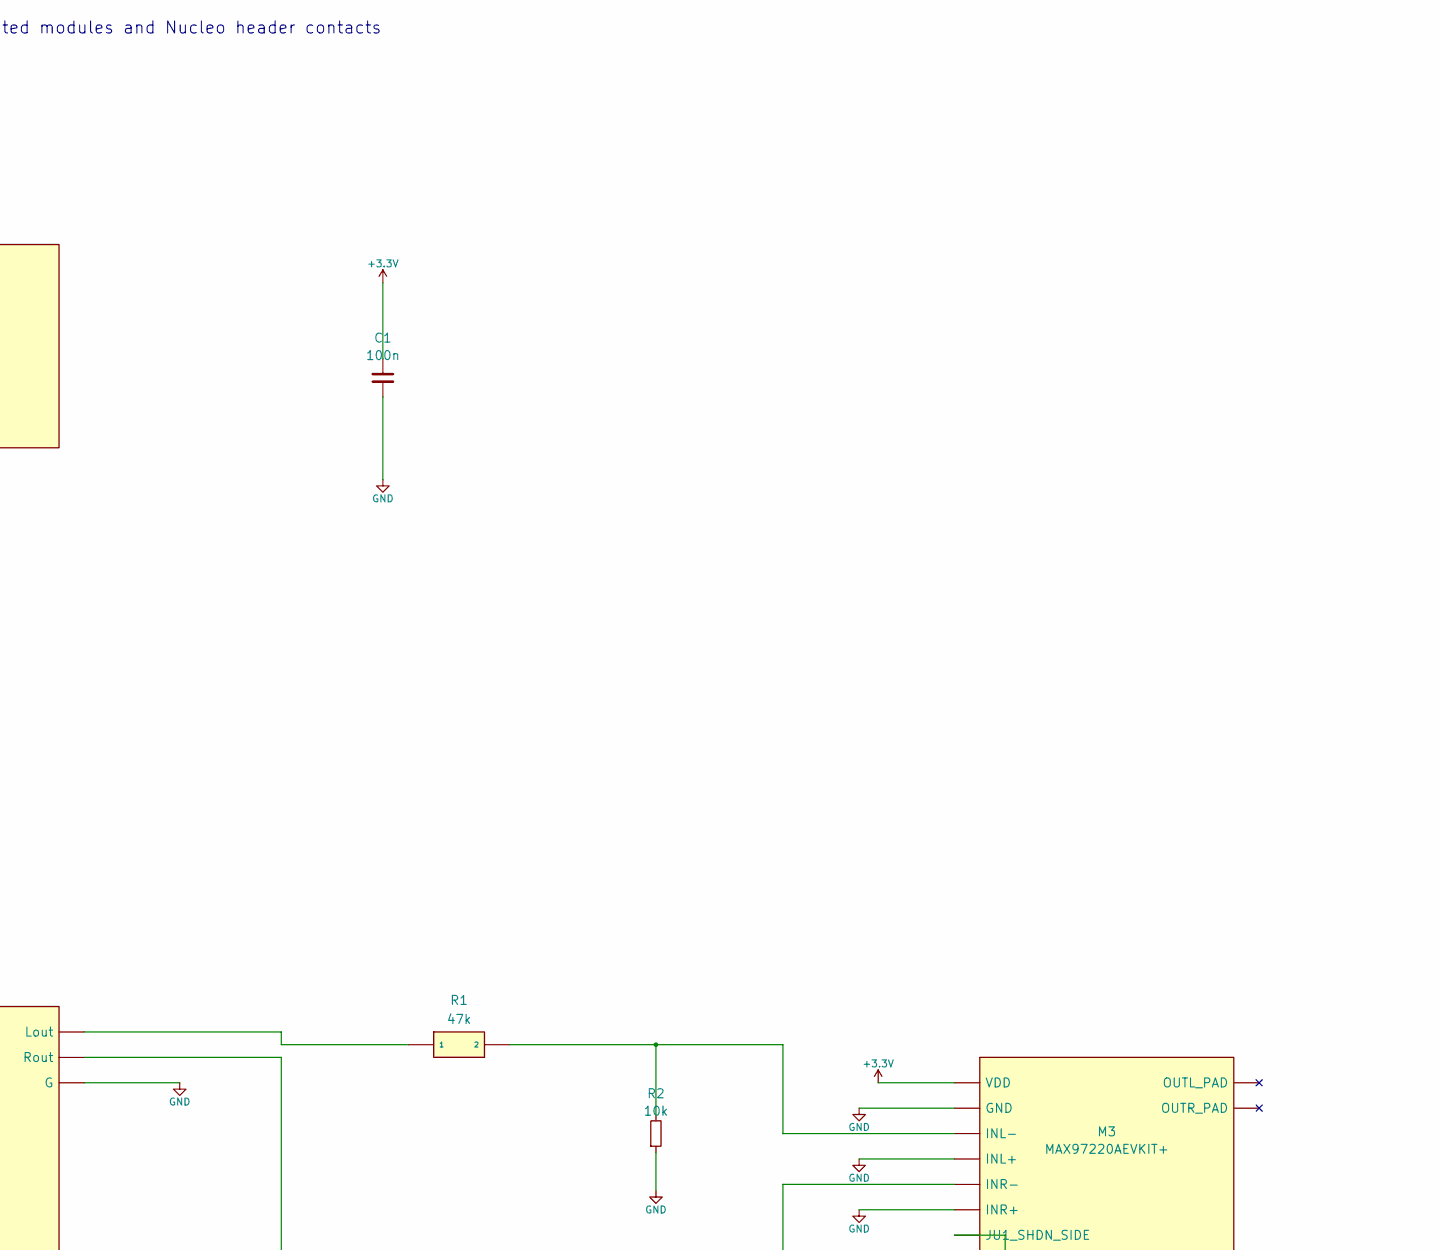
[picture p15: schematic AURA_circuit.kicad_sch, part in row 1, column 2]

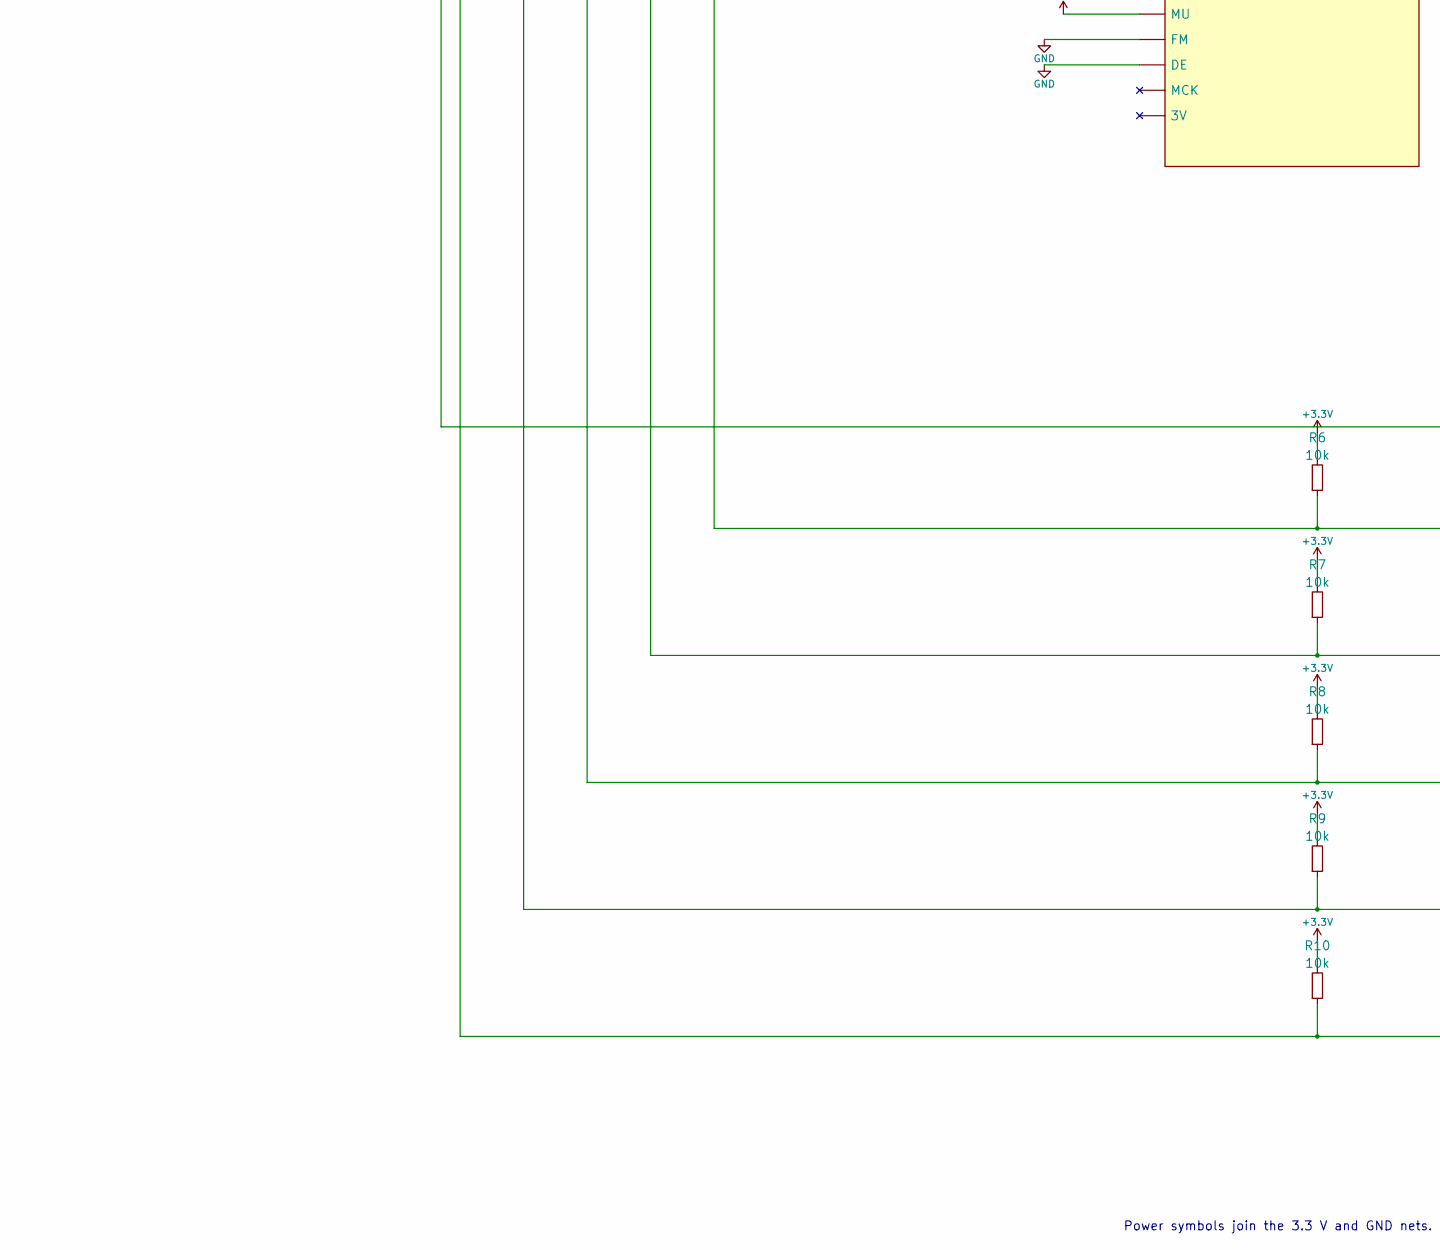
[picture p16: schematic AURA_circuit.kicad_sch, part in row 2, column 1]

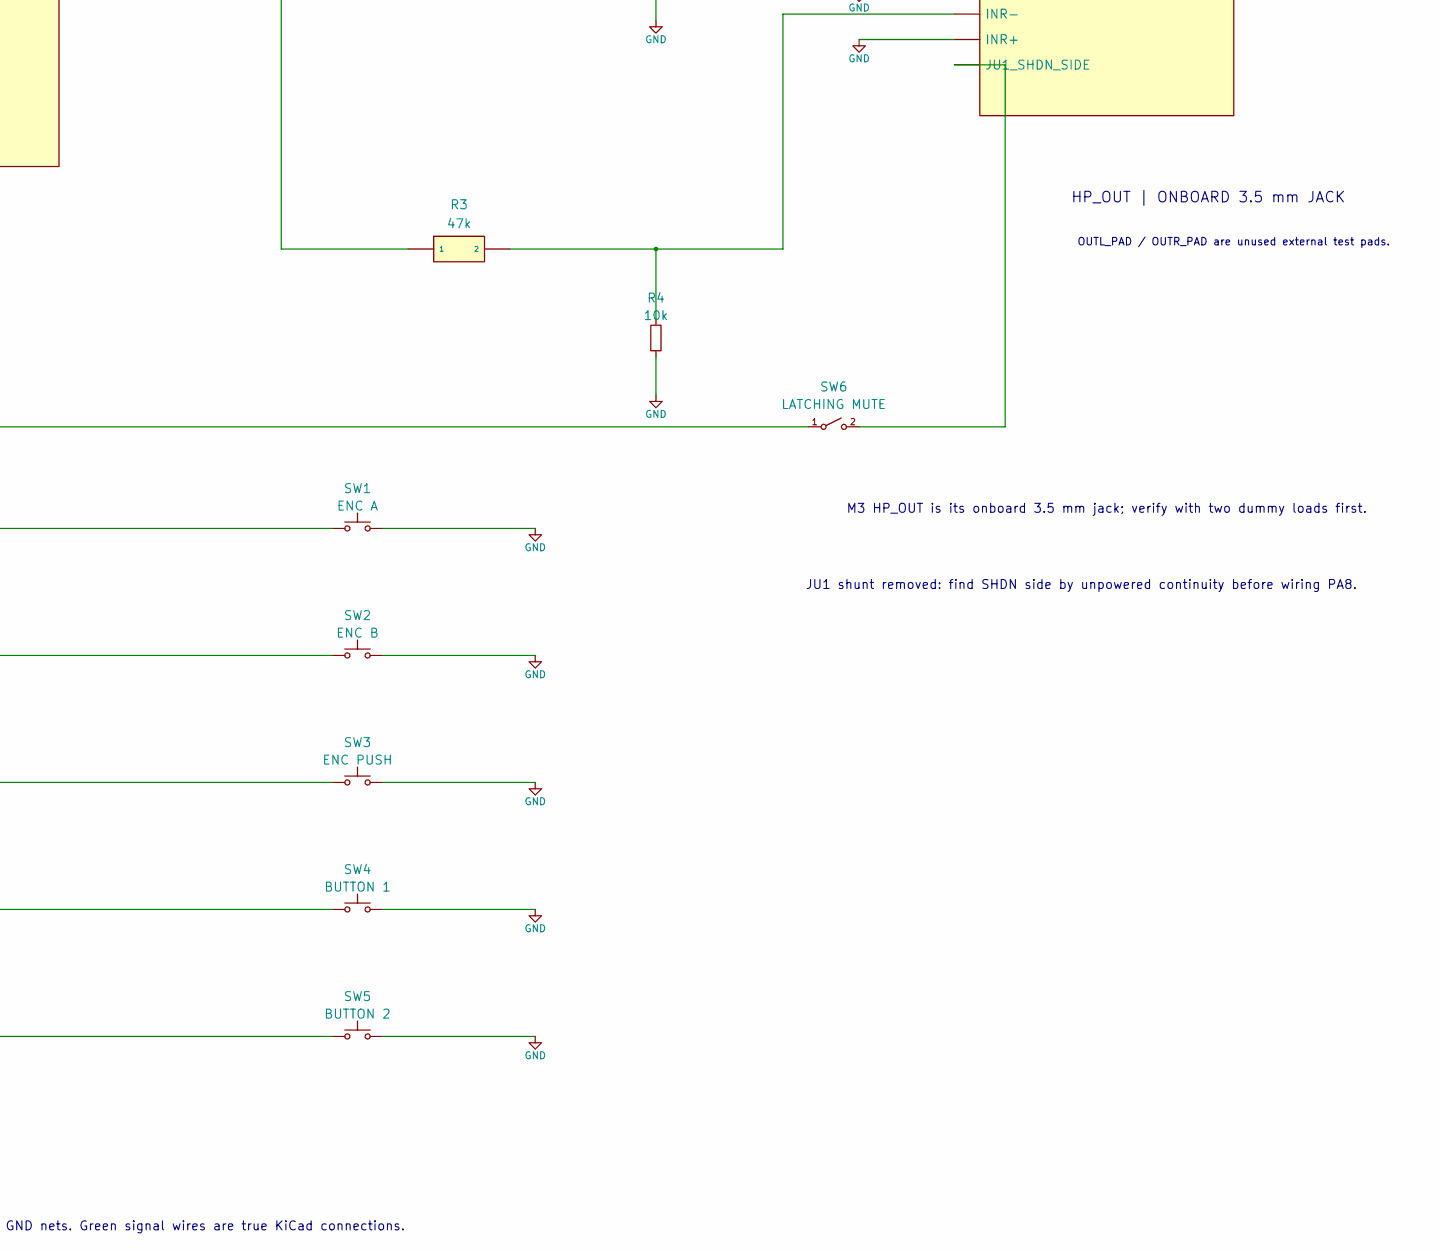
[picture p17: schematic AURA_circuit.kicad_sch, part in row 2, column 2]

Parts:
C1: 100n
J1: NUCLEO-F411RE CN7/CN10
M1: INMP441 module
M2: PCM5102 #6250
M3: MAX97220AEVKIT+
R1, R3: 47k
R2, R4, R6, R7, R8, R9, R10: 10k
R5: 100k
SW1: ENC A
SW2: ENC B
SW3: ENC PUSH
SW4: BUTTON 1
SW5: BUTTON 2
SW6: LATCHING MUTE

Connections:
+3.3V: C1.1, C1.2, J1.CN7-16_3V3, J1.CN7-20_GND, J1.CN10-20_GND, M1.GND, M1.L/R, M1.VDD, M2.DE, M2.FIL, M2.FM, M2.G, M2.GND, M2.MU, M2.VIN, M3.GND, M3.INL+, M3.INR+, M3.VDD, R2.2, R4.2, R5.2, R6.1, R7.1, R8.1, R9.1, R10.1, SW1.2, SW2.2, SW3.2, SW4.2, SW5.2
unnamed: J1.CN7-28_PA0, R6.2, SW1.1
unnamed: J1.CN7-30_PA1, R7.2, SW2.1
unnamed: J1.CN7-32_PA4, R8.2, SW3.1
unnamed: J1.CN7-34_PB0, R9.2, SW4.1
unnamed: J1.CN10-16_PB12_WS, M1.WS, M2.WSEL
unnamed: J1.CN10-23_PA8, SW6.1 (A)
unnamed: J1.CN10-24_PB1, R10.2, SW5.1
unnamed: J1.CN10-26_PB15_TX, M2.DIN
unnamed: J1.CN10-28_PB14_RX, M1.SD, R5.1
unnamed: J1.CN10-30_PB13_BCK, M1.SCK, M2.BCK
unnamed: M2.Lout, R1.1
unnamed: M2.Rout, R3.1
unnamed: M3.INL-, R1.2, R2.1
unnamed: M3.INR-, R3.2, R4.1
unnamed: M3.JU1_SHDN_SIDE, SW6.2 (B)

Notes on the sheet:
AURA | WIRED CIRCUIT VIEW | documented modules and Nucleo header contacts
HP_OUT | ONBOARD 3.5 mm JACK
OUTL_PAD / OUTR_PAD are unused external test pads.
M3 HP_OUT is its onboard 3.5 mm jack; verify with two dummy loads first.
JU1 shunt removed: find SHDN side by unpowered continuity before wiring PA8.
Power symbols join the 3.3 V and GND nets. Green signal wires are true KiCad connections.
