ayushp06/hackathon-fa26/(commit log)

2026-10-24 Initial project files
    [AURA.kicad_sch, AURA_breadboard.kicad_sch, AURA_circuit.kicad_sch, BOM.csv]
2026-10-24 Implement automatic calibration mock flow
2026-10-24 Centralize app state and add mock device transport
2026-10-25 Complete hearing test report import flow
2026-10-25 Add experimental wired-headphone hearing test
2026-10-25 Frame desktop web preview as iPhone
2026-10-25 Round calibration button and use settings gear
2026-10-25 Release Wavelength-v2 STM32 dual-microphone NLMS audio prototype
2026-10-25 feat(firmware): learn explicit noise-strength corrections and validate recall
    [adaptive_audio.c, adaptive_audio.h, audio_controls.c, audio_controls.h, pc_audio.c]
2026-10-25 Add acknowledged learning reset flow
2026-10-25 test(adaptive-ml): align feedback contract with acknowledged app flow
